Mikrovawe/KiCad2/README.md

# Input Output device

School assignment

In this assignment I received the schematic for this input/output device.
My task was to design the functional blocks and create the documentation as well as designing the 4-layer pcb using KiCad.

In file XX there is the planning of the design
