Mikrovawe/KiCad2/Toiminnalliset_Lohkot.docx

## AI

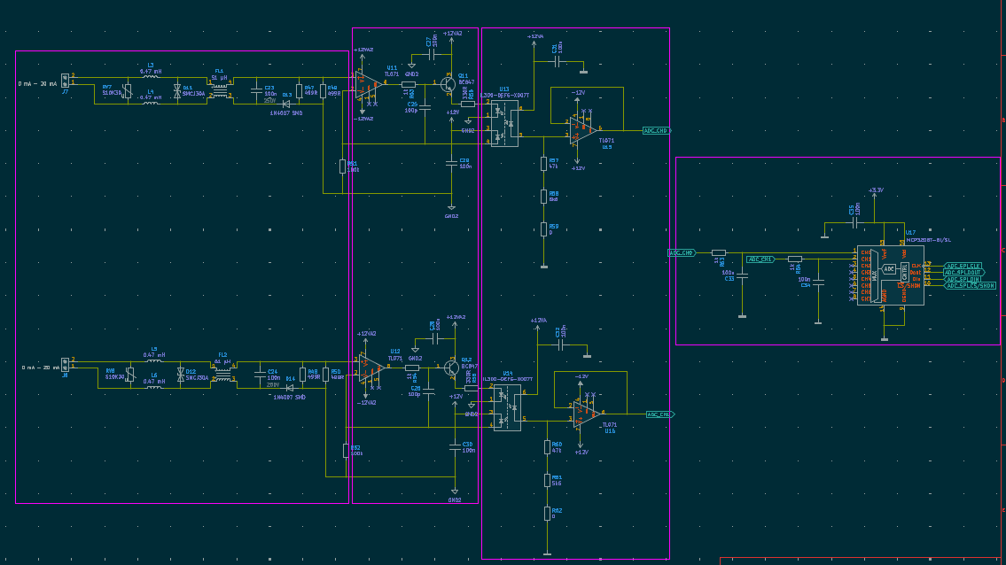
[picture p1: figure]

Lohkot vasemmalta oikealle:

AI – Input -> vasempaan reunaan

AI – Analog improver -> keskemmälle. U11: C54, C58 U12: C61, C64

AI – ADC Buffer -> keskemmälle. U15: C52, C55. U16: C59, C62

AI – ADC -> lähelle cpu:ta, kaukana analogisista signaaleista.

## AO

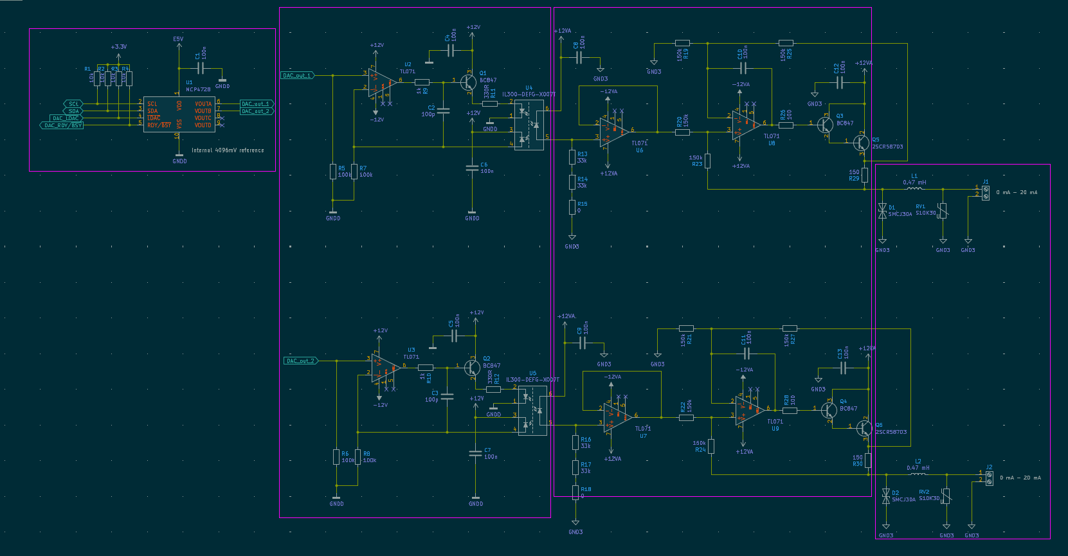
[picture p2: figure]

Lohkot vasemmalta oikealle:

AO – DAC -> CPU:n lähelle, eristyksiin analogisesta signaalista

AO – Analog Improver -> keskemmälle, U2: C65, C68. U3: C36, C44

AO – Output Driver -> keskemmälle, U6: C53, C56. U7: C60, C63. U8: C66, C69 U9: C71, C72

AO – Output -> oikealle reunaan

## DI

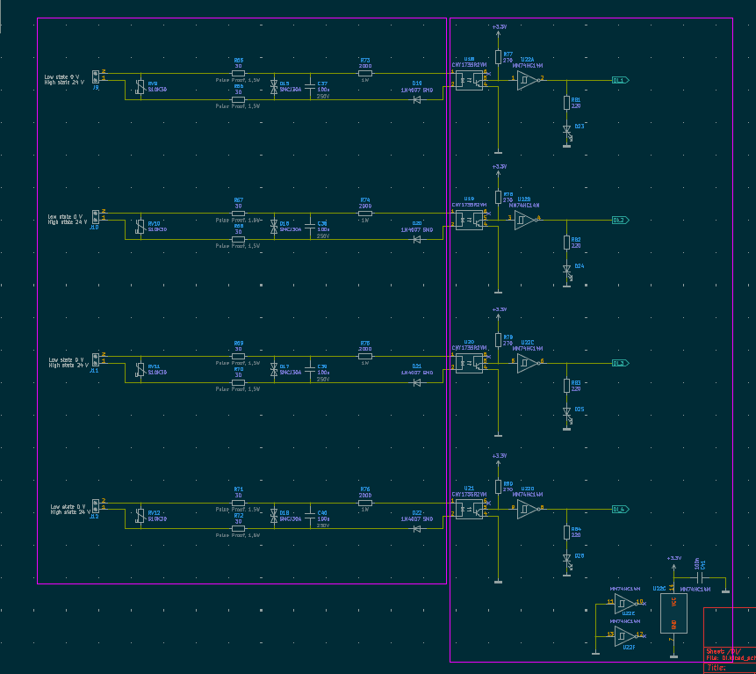
[picture p3: figure]

Lohkot vasemmalta oikealle:

DI – input -> vasen reuna, eristyksiin analogisesta signaalista

DI – Signal improver, lähelle CPU:ta,

## DO

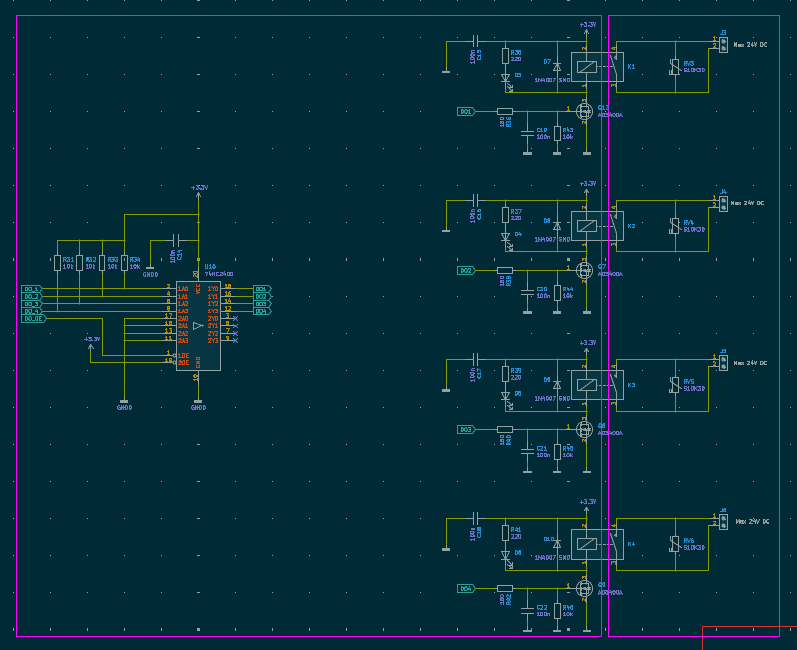
[picture p4: figure]

Lohkot vasemmalta oikealle:

DO – logics, lähelle CPU:ta, erilleen analogisista signaaleista.

DO – Output, oikeaan reunaan

## Power

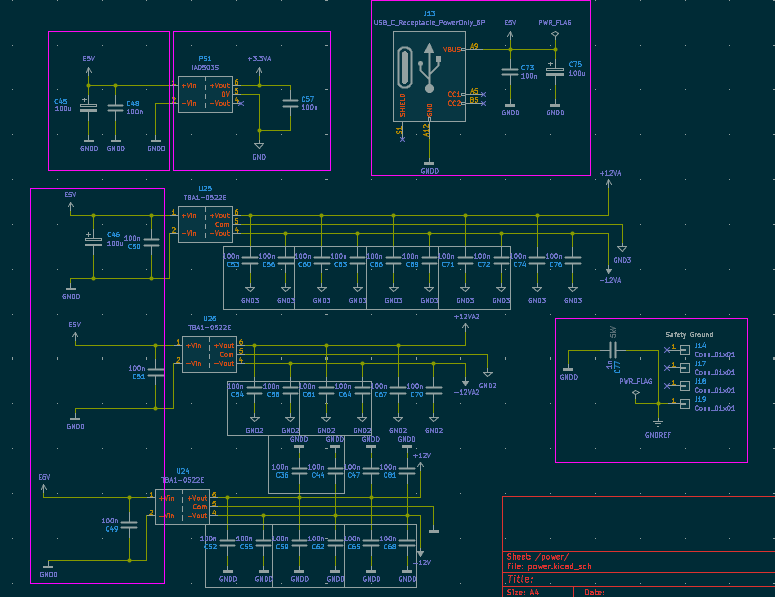
[picture p5: figure]

Lohkot vasemmalta oikealle:

Power – before 12V amp, ylös reunaan

Power – After 12V amp, ei laatikoitu, koska hajautettu ohituskondensaattoreihin.

Power – before 3.3V amp, ylös reunaan

Power – after 3.3V amp, ylös reunaan, erilleen 12V:stä

Power – Input, ylös

Power – Safety ground, jonnekin minne sattuu mahtumaan.

## Communication

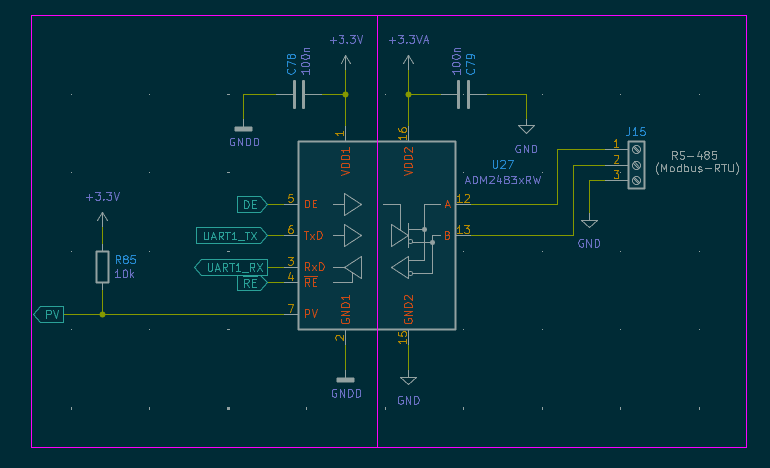
[picture p6: figure]

## CPU

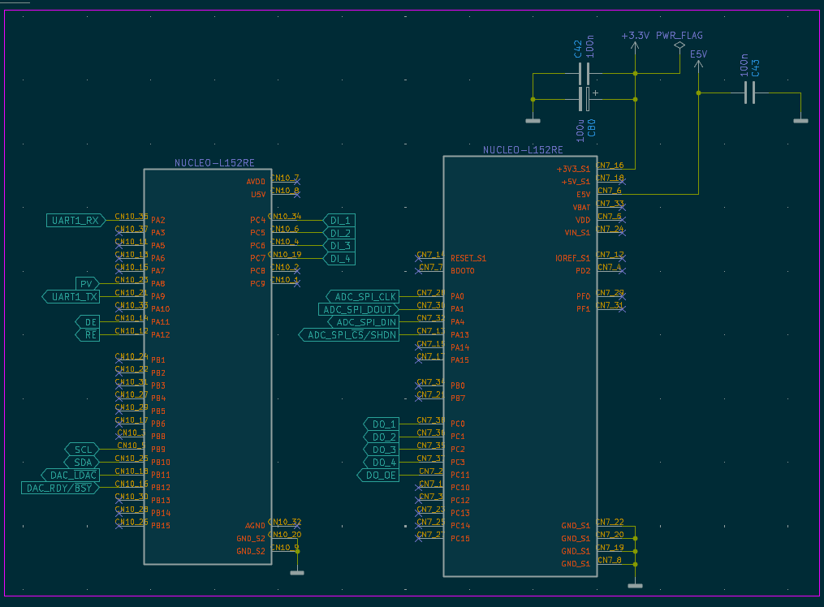
[picture p7: figure]
