Mikrovawe/KiCad2/IO_device.kicad_pcb

## KiCad design IO_device.kicad_pcb (2026-03-13)

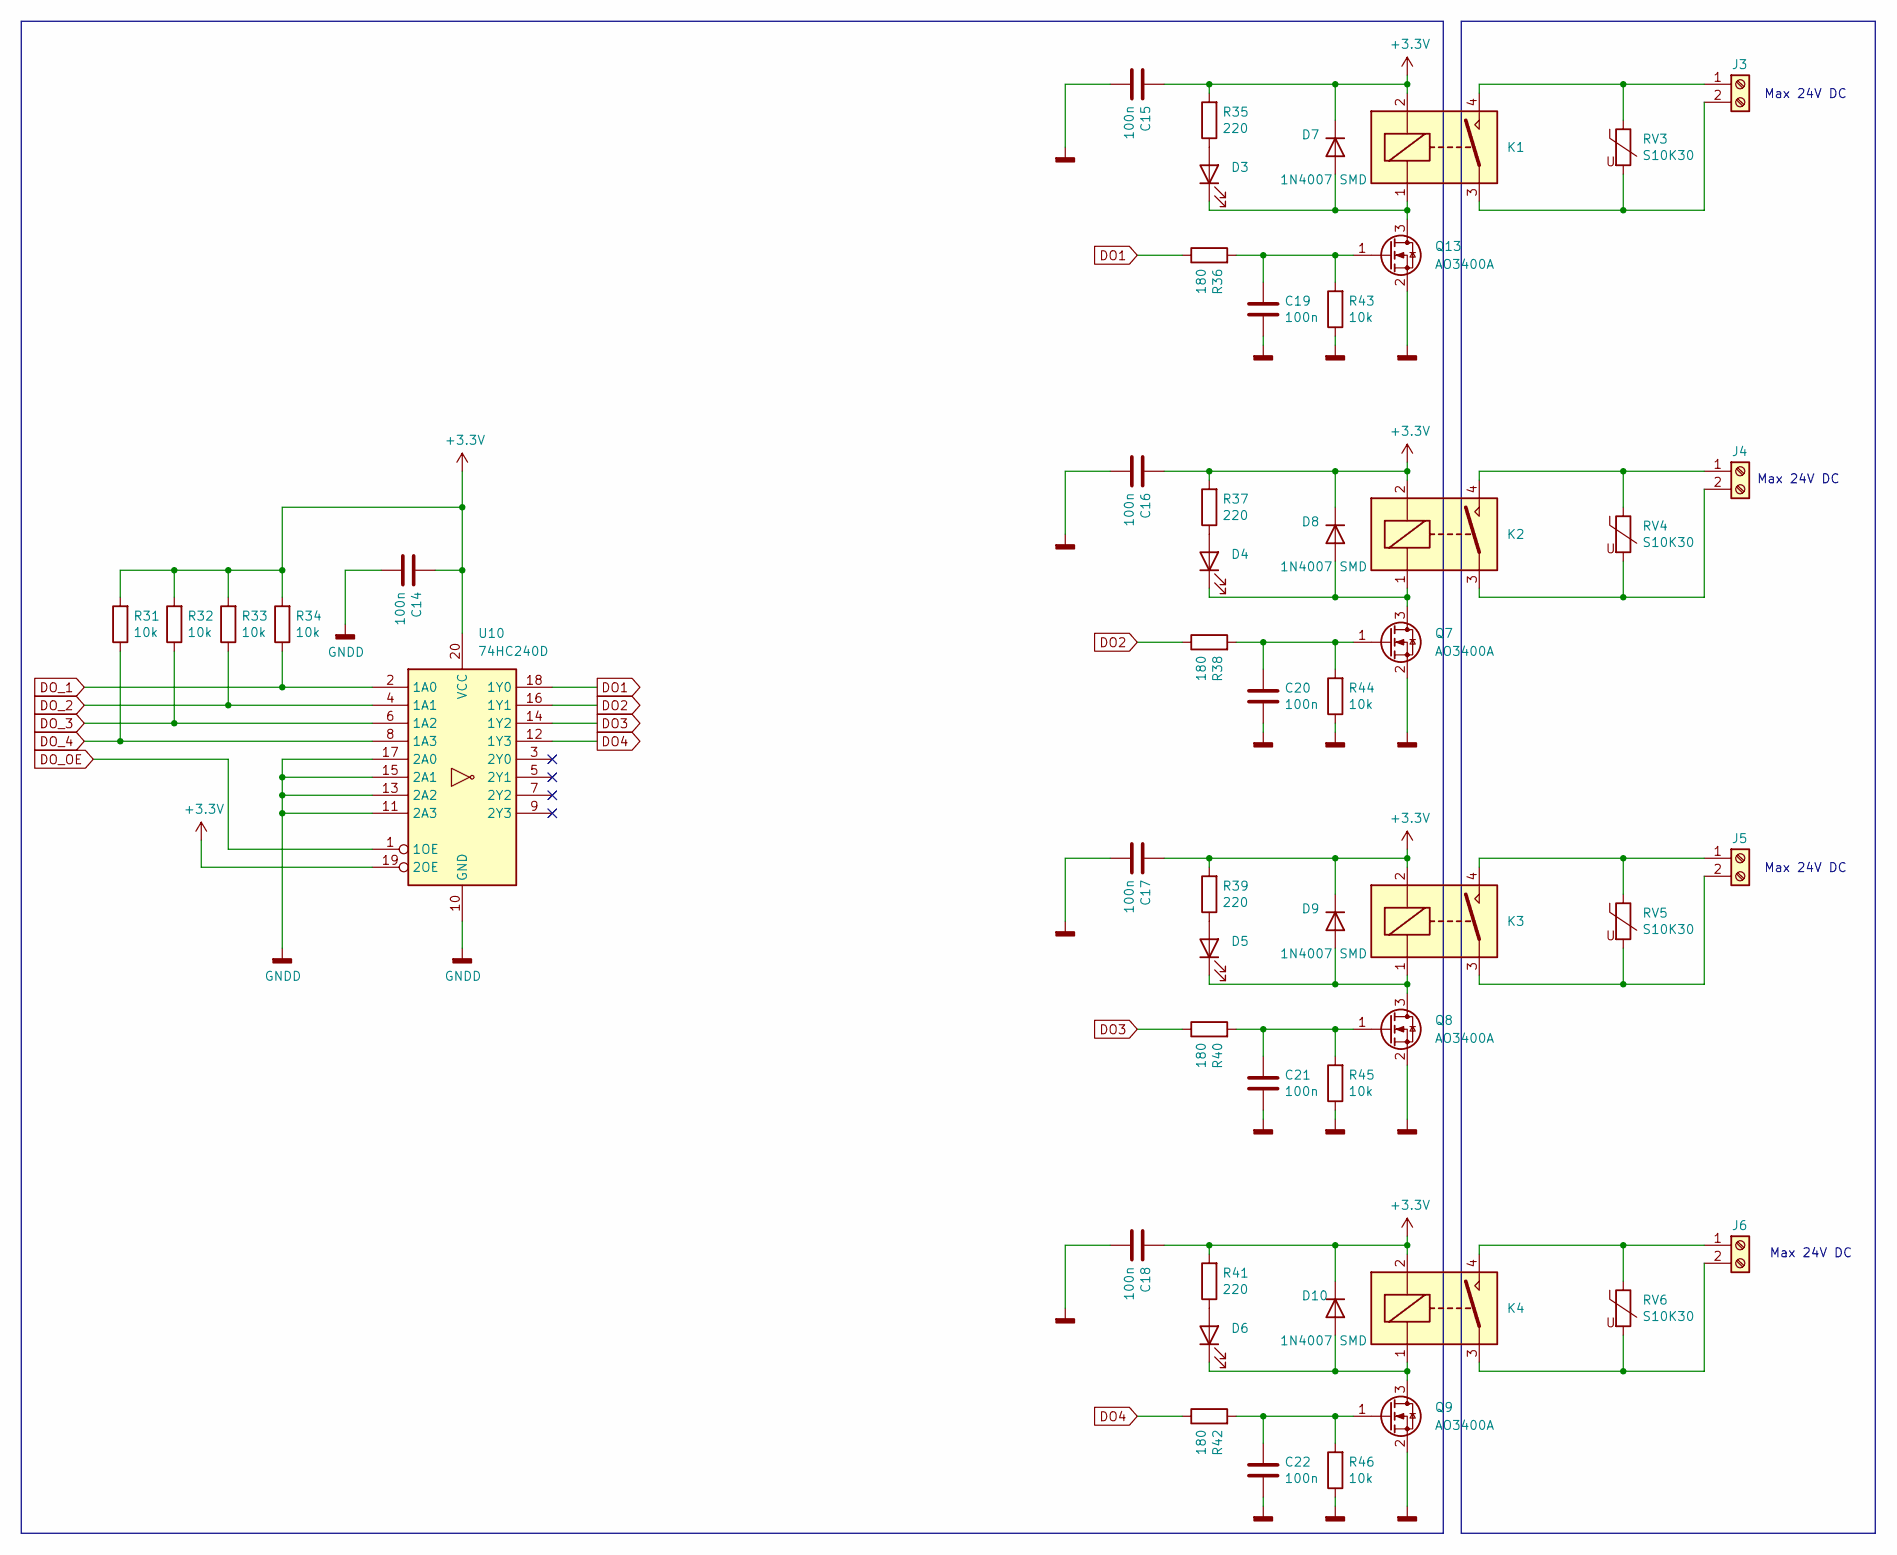
[picture p8: schematic DO.kicad_sch]

Parts:
C14, C15, C16, C17, C18, C19, C20, C21, C22: 100n; C_1206_3216Metric
D3, D4, D5, D6: Green LED 3mm; D_1206_3216Metric
D7, D8, D9, D10: 1N4007 SMD; D_SOD-123
J3, J4, J5, J6: Screw_Terminal_01x02; TerminalBlock_Phoenix_MKDS-3-2-5.08_1x02_P5.08mm_Horizontal
K1, K2, K3, K4: SDT-S-103DMR,000; 1461267-1
Q7, Q8, Q9, Q13: AO3400A; SOT-23
R31, R32, R33, R34, R43, R44, R45, R46: 10k; R_1206_3216Metric
R35, R37, R39, R41: 220; R_1206_3216Metric
R36, R38, R40, R42: 180; R_1206_3216Metric
RV3, RV4, RV5, RV6: S10K30; RV_Disc_D12mm_W5.1mm_P7.5mm
U10: 74HC240D; SOIC-20W_7.5x12.8mm_P1.27mm

Connections:
+3.3V: C14.1, C15.1, C16.1, C17.1, C18.1, D7.1 (K), D8.1 (K), D9.1 (K), D10.1 (K), K1.2, K2.2, K3.2, K4.2, R31.2, R32.2, R33.2, R34.2, R35.2, R37.2, R39.2, R41.2, U10.19 (2OE), U10.20 (VCC); also elsewhere on the board
DO1: R36.1, U10.18 (1Y0)
DO2: R38.1, U10.16 (1Y1)
DO3: R40.1, U10.14 (1Y2)
DO4: R42.1, U10.12 (1Y3)
DO_1: R34.1, U10.2 (1A0); also elsewhere on the board
DO_2: R33.1, U10.4 (1A1); also elsewhere on the board
DO_3: R32.1, U10.6 (1A2); also elsewhere on the board
DO_4: R31.1, U10.8 (1A3); also elsewhere on the board
DO_OE: U10.1 (1OE); also elsewhere on the board
GNDD: C14.2, C15.2, C16.2, C17.2, C18.2, C19.2, C20.2, C21.2, C22.2, Q7.2 (S), Q8.2 (S), Q9.2 (S), Q13.2 (S), R43.1, R44.1, R45.1, R46.1, U10.10 (GND), U10.11 (2A3), U10.13 (2A2), U10.15 (2A1), U10.17 (2A0); also elsewhere on the board
unnamed: D3.2 (A), R35.1
unnamed: D3.1 (K), D7.2 (A), K1.1, Q13.3 (D)
unnamed: D4.2 (A), R37.1
unnamed: D4.1 (K), D8.2 (A), K2.1, Q7.3 (D)
unnamed: D5.2 (A), R39.1
unnamed: D5.1 (K), D9.2 (A), K3.1, Q8.3 (D)
unnamed: D6.2 (A), R41.1
unnamed: D6.1 (K), D10.2 (A), K4.1, Q9.3 (D)
unnamed: J3.1, K1.4, RV3.1
unnamed: J3.2, K1.3, RV3.2
unnamed: J4.1, K2.4, RV4.1
unnamed: J4.2, K2.3, RV4.2
unnamed: J5.1, K3.4, RV5.1
unnamed: J5.2, K3.3, RV5.2
unnamed: J6.1, K4.4, RV6.1
unnamed: J6.2, K4.3, RV6.2
unnamed: C20.1, Q7.1 (G), R38.2, R44.2
unnamed: C21.1, Q8.1 (G), R40.2, R45.2
unnamed: C22.1, Q9.1 (G), R42.2, R46.2
unnamed: C19.1, Q13.1 (G), R36.2, R43.2

Notes on the sheet:
Max 24V DC

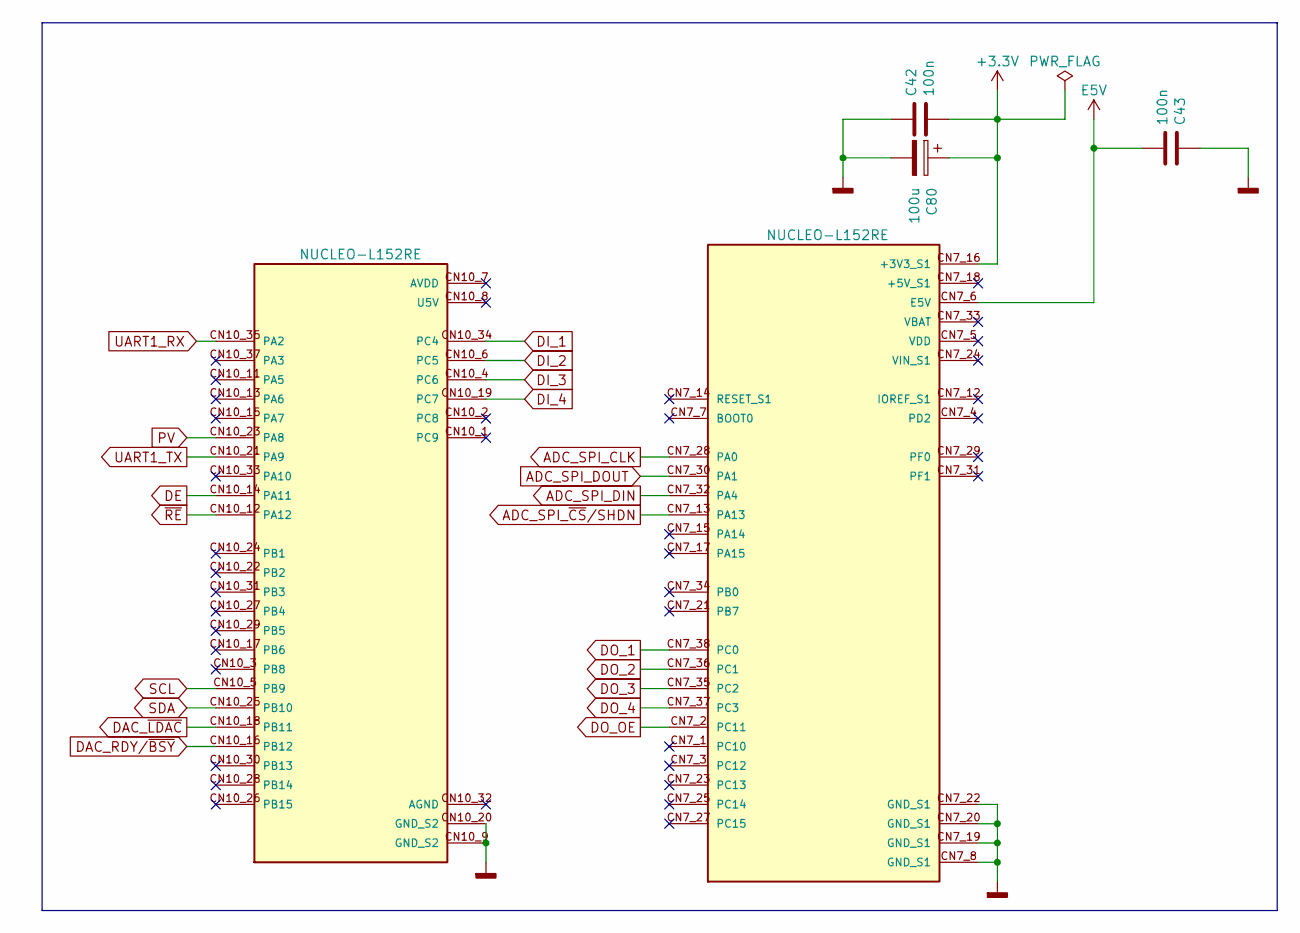
[picture p9: schematic CPU.kicad_sch]

Parts:
C42, C43: 100n; C_1206_3216Metric; Voltage 250V
C80: 100u; CP_Elec_6.3x7.7
U28: NUCLEO-L152RE; ST_NUCLEO-F303RE; PARTREV 14

Connections:
+3.3V: C42.2, C80.1, U28.CN7_16 (+3V3_S1); also elsewhere on the board
ADC_SPI_CLK: U28.CN7_28 (PA0); also elsewhere on the board
ADC_SPI_DIN: U28.CN7_32 (PA4); also elsewhere on the board
ADC_SPI_DOUT: U28.CN7_30 (PA1); also elsewhere on the board
ADC_SPI_~CS/SHDN: U28.CN7_13 (PA13); also elsewhere on the board
DAC_RDY/~BSY: U28.CN10_16 (PB12); also elsewhere on the board
DAC_~LDAC: U28.CN10_18 (PB11); also elsewhere on the board
DE: U28.CN10_14 (PA11); also elsewhere on the board
DI_1: U28.CN10_34 (PC4); also elsewhere on the board
DI_2: U28.CN10_6 (PC5); also elsewhere on the board
DI_3: U28.CN10_4 (PC6); also elsewhere on the board
DI_4: U28.CN10_19 (PC7); also elsewhere on the board
DO_1: U28.CN7_38 (PC0); also elsewhere on the board
DO_2: U28.CN7_36 (PC1); also elsewhere on the board
DO_3: U28.CN7_35 (PC2); also elsewhere on the board
DO_4: U28.CN7_37 (PC3); also elsewhere on the board
DO_OE: U28.CN7_2 (PC11); also elsewhere on the board
E5V: C43.2, U28.CN7_6 (E5V); also elsewhere on the board
GNDD: C42.1, C43.1, C80.2, U28.CN7_8 (GND_S1), U28.CN7_19 (GND_S1), U28.CN7_20 (GND_S1), U28.CN7_22 (GND_S1), U28.CN10_9 (GND_S2), U28.CN10_20 (GND_S2); also elsewhere on the board
PV: U28.CN10_23 (PA8); also elsewhere on the board
SCL: U28.CN10_5 (PB9); also elsewhere on the board
SDA: U28.CN10_25 (PB10); also elsewhere on the board
UART1_RX: U28.CN10_35 (PA2); also elsewhere on the board
UART1_TX: U28.CN10_21 (PA9); also elsewhere on the board
~RE: U28.CN10_12 (PA12); also elsewhere on the board

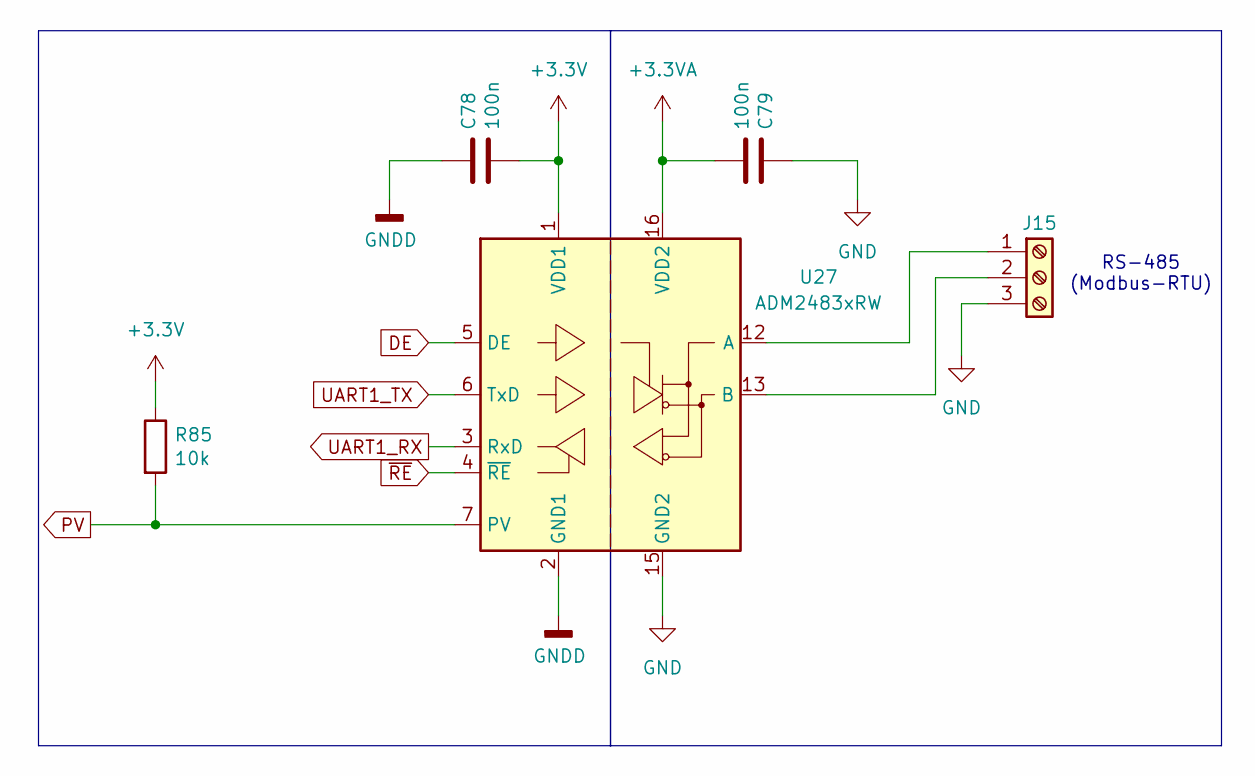
[picture p10: schematic Communication.kicad_sch]

Parts:
C78, C79: 100n; C_1206_3216Metric; Voltage 250V
J15: Screw_Terminal_01x03; TerminalBlock_Phoenix_MKDS-3-3-5.08_1x03_P5.08mm_Horizontal
R85: 10k; C_1206_3216Metric
U27: ADM2483xRW; SOIC-16W_7.5x10.3mm_P1.27mm

Connections:
+3.3V: C78.2, R85.1, U27.1 (VDD1); also elsewhere on the board
+3.3VA: C79.2, U27.16 (VDD2); also elsewhere on the board
DE: U27.5 (DE); also elsewhere on the board
GND: C79.1, J15.3, U27.9 (GND2), U27.15 (GND2); also elsewhere on the board
GNDD: C78.1, U27.2 (GND1), U27.8 (GND1); also elsewhere on the board
unnamed: J15.1, U27.12 (A)
unnamed: J15.2, U27.13 (B)
PV: R85.2, U27.7 (PV); also elsewhere on the board
UART1_RX: U27.3 (RxD); also elsewhere on the board
UART1_TX: U27.6 (TxD); also elsewhere on the board
~RE: U27.4 (~RE); also elsewhere on the board

Notes on the sheet:
RS-485 (Modbus-RTU)

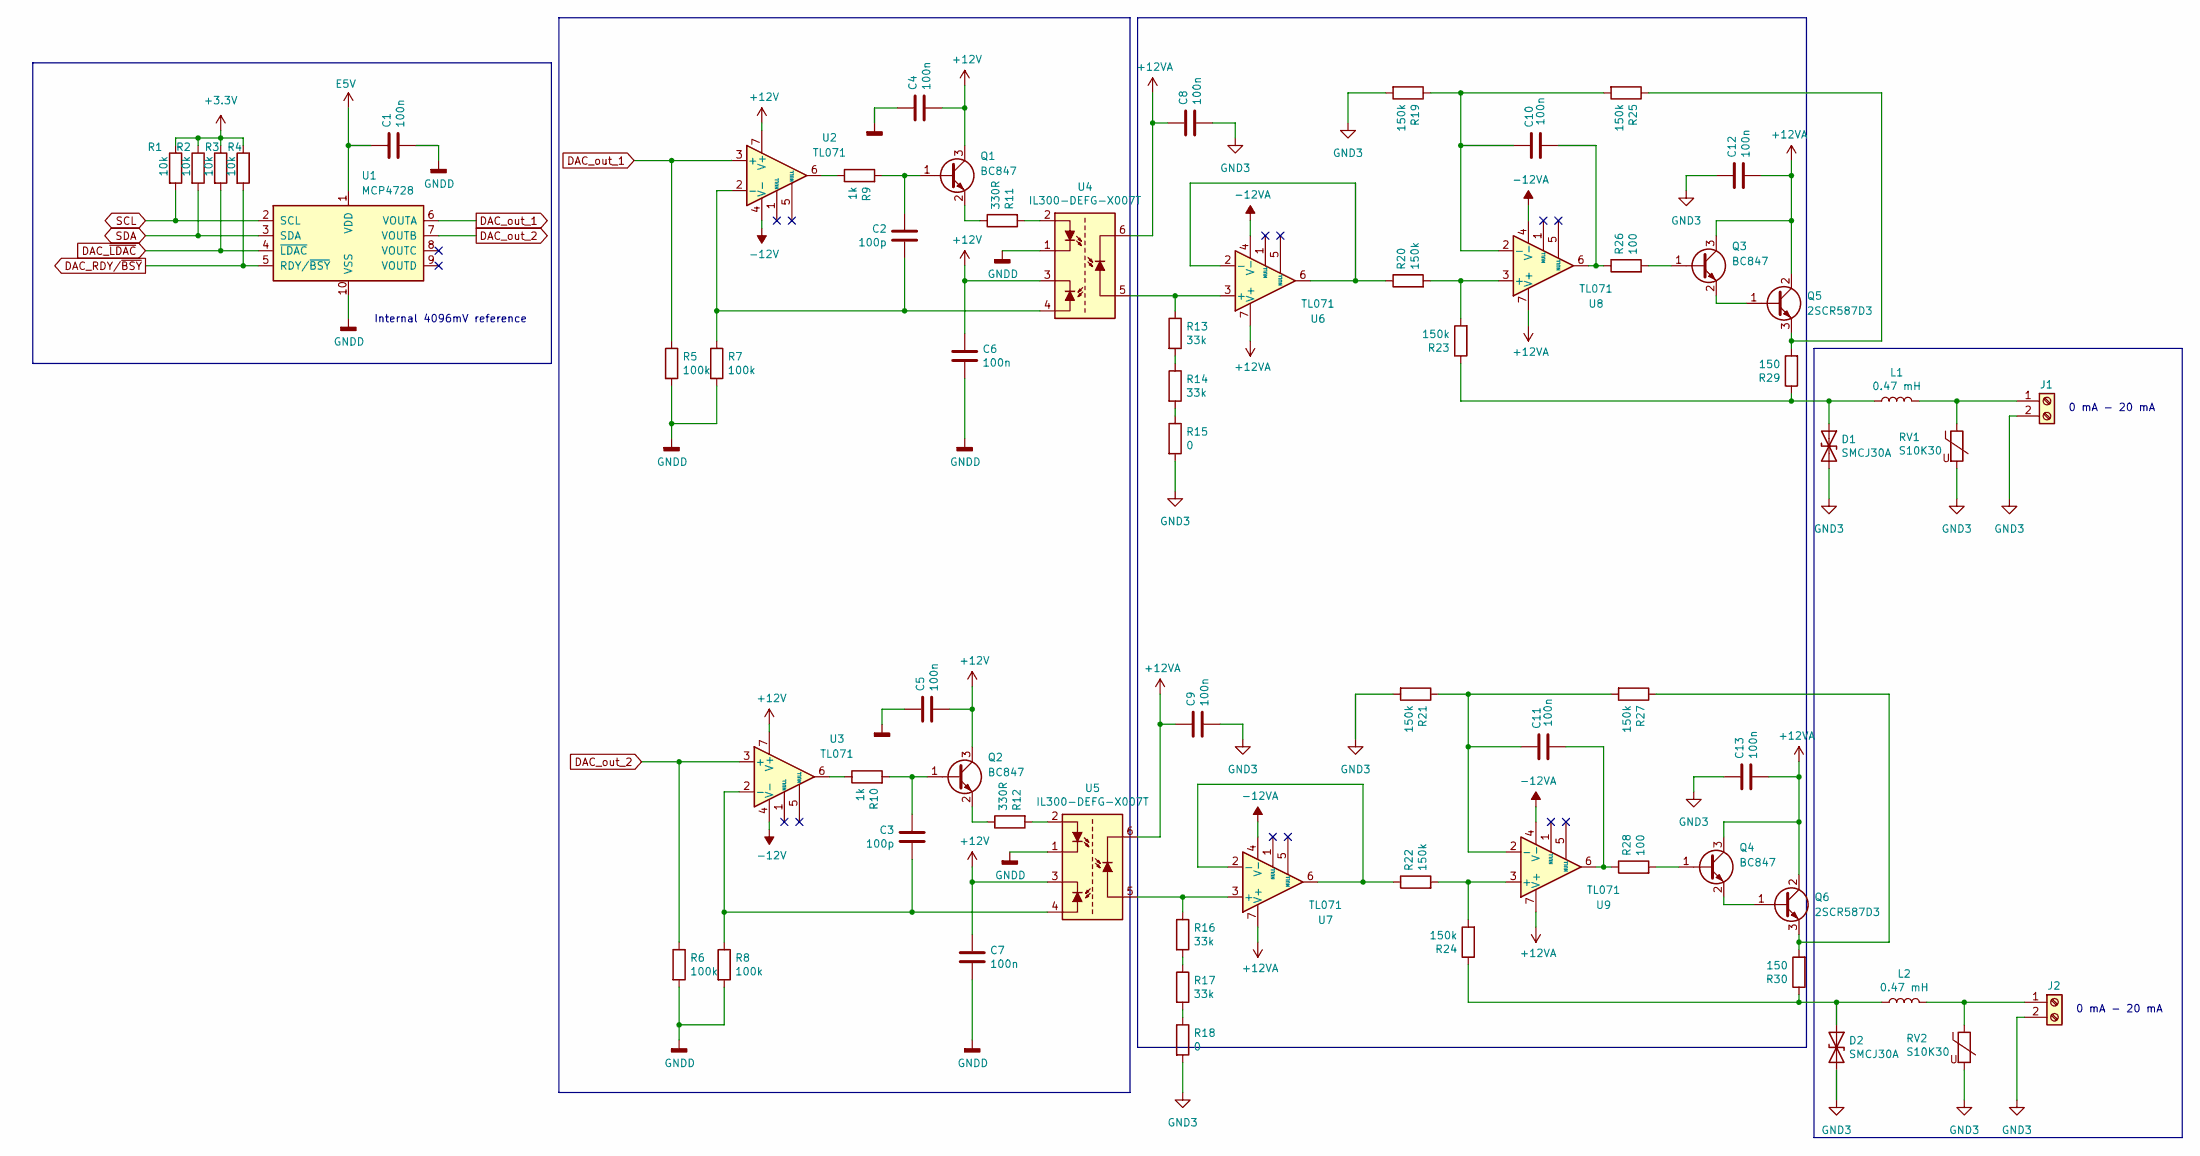
[picture p11: schematic AO.kicad_sch]

Parts:
C1, C4, C5, C8, C9, C12, C13: 100n; C_1206_3216Metric
C2, C3: 100p; C_1206_3216Metric
C6, C7, C10, C11: 100n; R_1206_3216Metric
D1, D2: SMCJ30A; D_SMC
J1, J2: Screw_Terminal_01x02; TerminalBlock_Phoenix_MKDS-3-2-5.08_1x02_P5.08mm_Horizontal
L1, L2: 0.47 mH; L_Radial_D7.8mm_P5.00mm_Fastron_07HCP
Q1, Q2, Q3, Q4: BC847; SOT-23
Q5, Q6: 2SCR587D3; TO-252-2
R1, R2, R3, R4: 10k; R_1206_3216Metric
R5, R6, R7, R8: 100k; R_1206_3216Metric
R9, R10: 1k; D_1206_3216Metric
R11, R12: 330R; R_1020_2550Metric
R13, R14, R16, R17: 33k; R_1206_3216Metric
R15, R18: 0; R_1206_3216Metric
R19, R20, R21, R22, R23, R24, R25, R27: 150k; C_1206_3216Metric
R26, R28: 100; C_1206_3216Metric
R29, R30: 150; C_1206_3216Metric
RV1, RV2: S10K30; RV_Disc_D12mm_W5.1mm_P7.5mm
U1: MCP4728; MSOP-10_3x3mm_P0.5mm
U2, U3, U6, U7, U8, U9: TL071; SOIC-8_3.9x4.9mm_P1.27mm
U4, U5: IL300-DEFG-X007T; DIP-8_W8.89mm_SMDSocket_LongPads

Connections:
+3.3V: R1.1, R2.1, R3.1, R4.1; also elsewhere on the board
+12V: C4.1, C5.1, C6.2, C7.2, Q1.3 (C), Q2.3 (C), U2.7 (V+), U3.7 (V+), U4.3, U5.3; also elsewhere on the board
+12VA: C8.2, C9.2, C12.1, C13.1, Q3.3 (C), Q4.3 (C), Q5.2 (C), Q6.2 (C), U4.6, U5.6, U6.7 (V+), U7.7 (V+), U8.7 (V+), U9.7 (V+); also elsewhere on the board
-12V: U2.4 (V-), U3.4 (V-); also elsewhere on the board
-12VA: U6.4 (V-), U7.4 (V-), U8.4 (V-), U9.4 (V-); also elsewhere on the board
DAC_RDY/~BSY: R4.2, U1.5 (RDY/~BSY); also elsewhere on the board
DAC_out_1: R5.1, U1.6 (VOUTA), U2.3 (+)
DAC_out_2: R6.1, U1.7 (VOUTB), U3.3 (+)
DAC_~LDAC: R3.2, U1.4 (~LDAC); also elsewhere on the board
E5V: C1.2, U1.1 (VDD); also elsewhere on the board
GND3: C8.1, C9.1, C12.2, C13.2, D1.2 (A2), D2.2 (A2), J1.2, J2.2, R15.2, R18.2, R19.2, R21.2, RV1.2, RV2.2; also elsewhere on the board
GNDD: C1.1, C4.2, C5.2, C6.1, C7.1, R5.2, R6.2, R7.2, R8.2, U1.10 (VSS), U4.1, U5.1; also elsewhere on the board
unnamed: C10.1, R26.1, U8.6
unnamed: C11.1, R28.1, U9.6
unnamed: D1.1 (A1), L1.2, R23.1, R29.1
unnamed: D2.1 (A1), L2.2, R24.1, R30.1
unnamed: J1.1, L1.1, RV1.1
unnamed: J2.1, L2.1, RV2.1
unnamed: C2.1, Q1.1 (B), R9.2
unnamed: Q1.2 (E), R11.1
unnamed: C3.1, Q2.1 (B), R10.2
unnamed: Q2.2 (E), R12.1
unnamed: Q3.1 (B), R26.2
unnamed: Q3.2 (E), Q5.1 (B)
unnamed: Q4.1 (B), R28.2
unnamed: Q4.2 (E), Q6.1 (B)
unnamed: Q5.3 (E), R25.1, R29.2
unnamed: Q6.3 (E), R27.1, R30.2
unnamed: R9.1, U2.6
unnamed: R10.1, U3.6
unnamed: R11.2, U4.2
unnamed: R12.2, U5.2
unnamed: R13.2, R14.1
unnamed: R14.2, R15.1
unnamed: R16.2, R17.1
unnamed: R17.2, R18.1
unnamed: C2.2, R7.1, U2.2 (-), U4.4
unnamed: C3.2, R8.1, U3.2 (-), U5.4
unnamed: R13.1, U4.5, U6.3 (+)
unnamed: R20.1, U6.2 (-), U6.6
unnamed: R16.1, U5.5, U7.3 (+)
unnamed: R22.1, U7.2 (-), U7.6
unnamed: R20.2, R23.2, U8.3 (+)
unnamed: C10.2, R19.1, R25.2, U8.2 (-)
unnamed: R22.2, R24.2, U9.3 (+)
unnamed: C11.2, R21.1, R27.2, U9.2 (-)
SCL: R1.2, U1.2 (SCL); also elsewhere on the board
SDA: R2.2, U1.3 (SDA); also elsewhere on the board

Notes on the sheet:
0 mA - 20 mA
Internal 4096mV reference

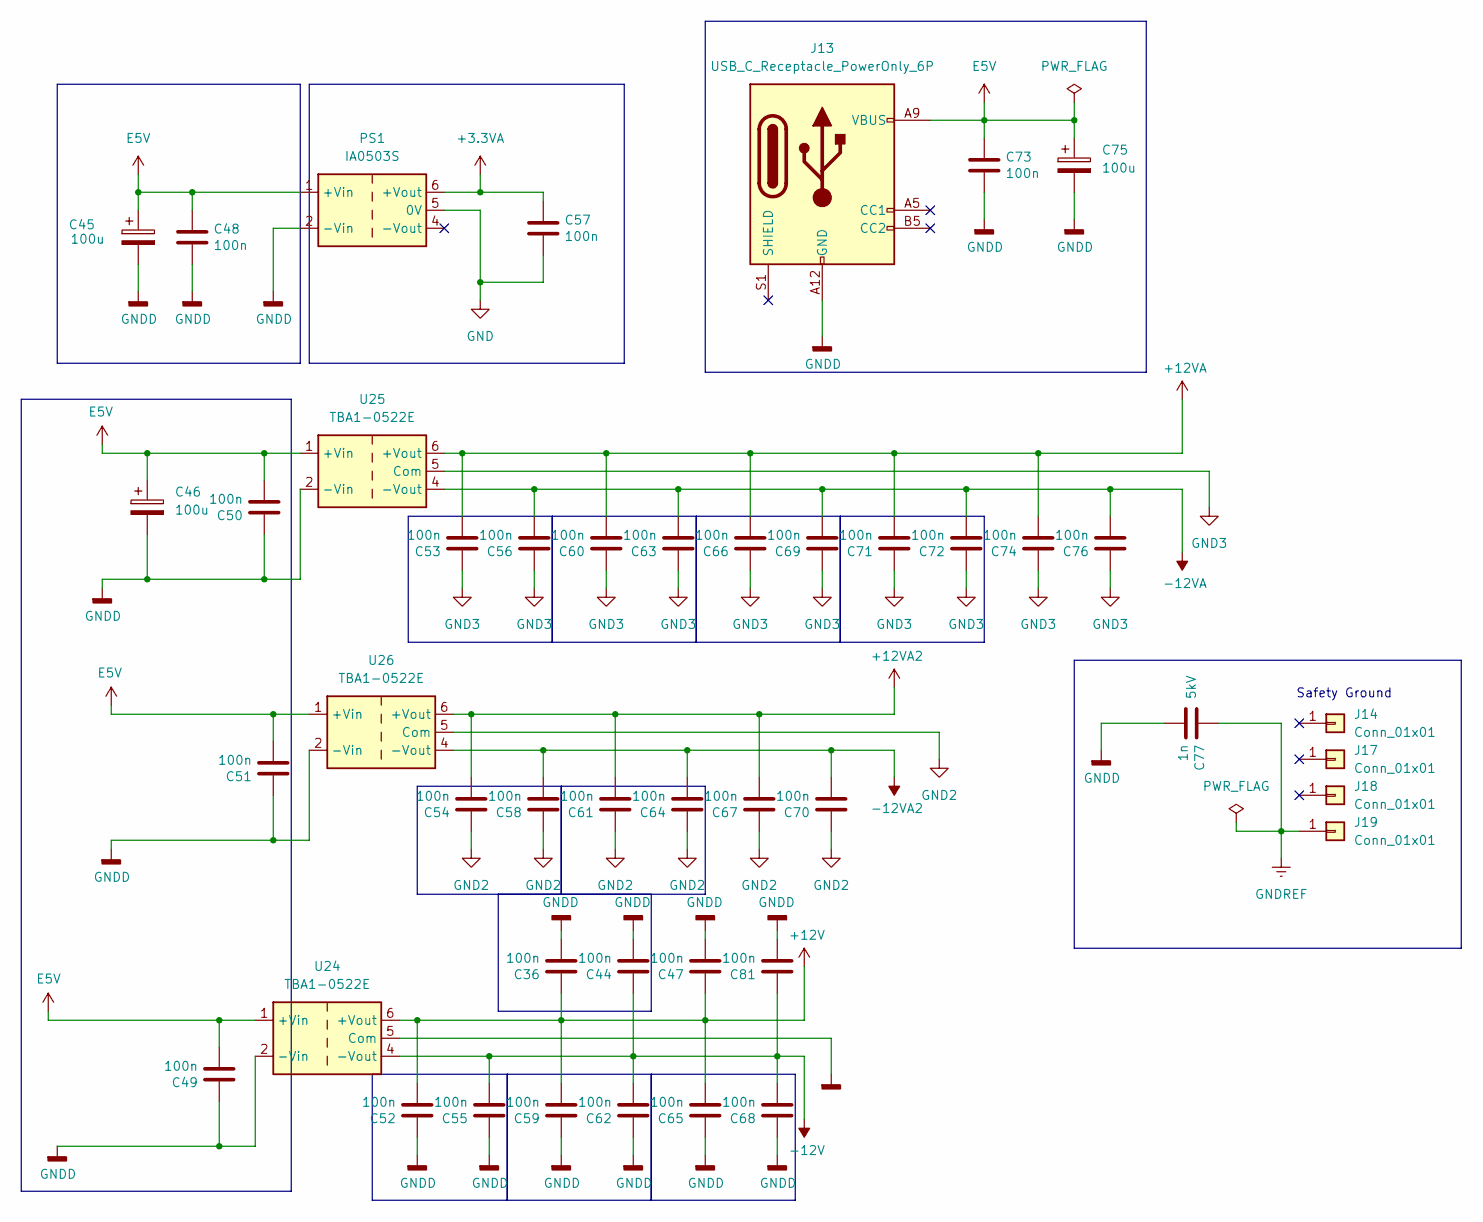
[picture p12: schematic power.kicad_sch]

Parts:
C36, C44, C47, C49, C50, C51, C52, C53, C54, C55, C56, C58, C59, C60, C61, C62, C63, C64, C65, C66, C67, C68, C69, C70, C71, C72, C74, C76, C81: 100n; C_1206_3216Metric
C45, C46, C75: 100u; CP_Elec_6.3x7.7
C48, C57, C73: 100n; C_1206_3216Metric; Voltage 250V
C77: 1n; C_2220_5750Metric; Voltage 5kV
J13: USB_C_Receptacle_PowerOnly_6P; CUI_UJC-HP-3-SMT-TR
J14, J17, J18, J19: Conn_01x01; MountingHole_3.5mm_Pad
PS1: IA0503S; Converter_DCDC_XP_POWER-IAxxxxS_THT
U24, U25, U26: TBA1-0522E; Converter_DCDC_TRACO_TBA1-xxxxE_Dual_THT

Connections:
+3.3VA: C57.1, PS1.6 (+Vout); also elsewhere on the board
+12V: C36.2, C47.2, C52.1, C59.1, C65.1, U24.6 (+Vout); also elsewhere on the board
+12VA: C53.1, C60.1, C66.1, C71.1, C74.1, U25.6 (+Vout); also elsewhere on the board
+12VA2: C54.1, C61.1, C67.1, U26.6 (+Vout); also elsewhere on the board
-12V: C44.2, C55.1, C62.1, C68.1, C81.2, U24.4 (-Vout); also elsewhere on the board
-12VA: C56.1, C63.1, C69.1, C72.1, C76.1, U25.4 (-Vout); also elsewhere on the board
-12VA2: C58.1, C64.1, C70.1, U26.4 (-Vout); also elsewhere on the board
E5V: C45.1, C46.1, C48.1, C49.1, C50.1, C51.1, C73.1, C75.1, J13.A9 (VBUS), J13.B9 (VBUS), PS1.1 (+Vin), U24.1 (+Vin), U25.1 (+Vin), U26.1 (+Vin); also elsewhere on the board
GND: C57.2, PS1.5 (0V); also elsewhere on the board
GND2: C54.2, C58.2, C61.2, C64.2, C67.2, C70.2, U26.5 (Com); also elsewhere on the board
GND3: C53.2, C56.2, C60.2, C63.2, C66.2, C69.2, C71.2, C72.2, C74.2, C76.2, U25.5 (Com); also elsewhere on the board
GNDD: C36.1, C44.1, C45.2, C46.2, C47.1, C48.2, C49.2, C50.2, C51.2, C52.2, C55.2, C59.2, C62.2, C65.2, C68.2, C73.2, C75.2, C77.2, C81.1, J13.A12 (GND), J13.B12 (GND), PS1.2 (-Vin), U24.2 (-Vin), U24.5 (Com), U25.2 (-Vin), U26.2 (-Vin); also elsewhere on the board
GNDREF: C77.1, J19.1

Notes on the sheet:
Safety Ground

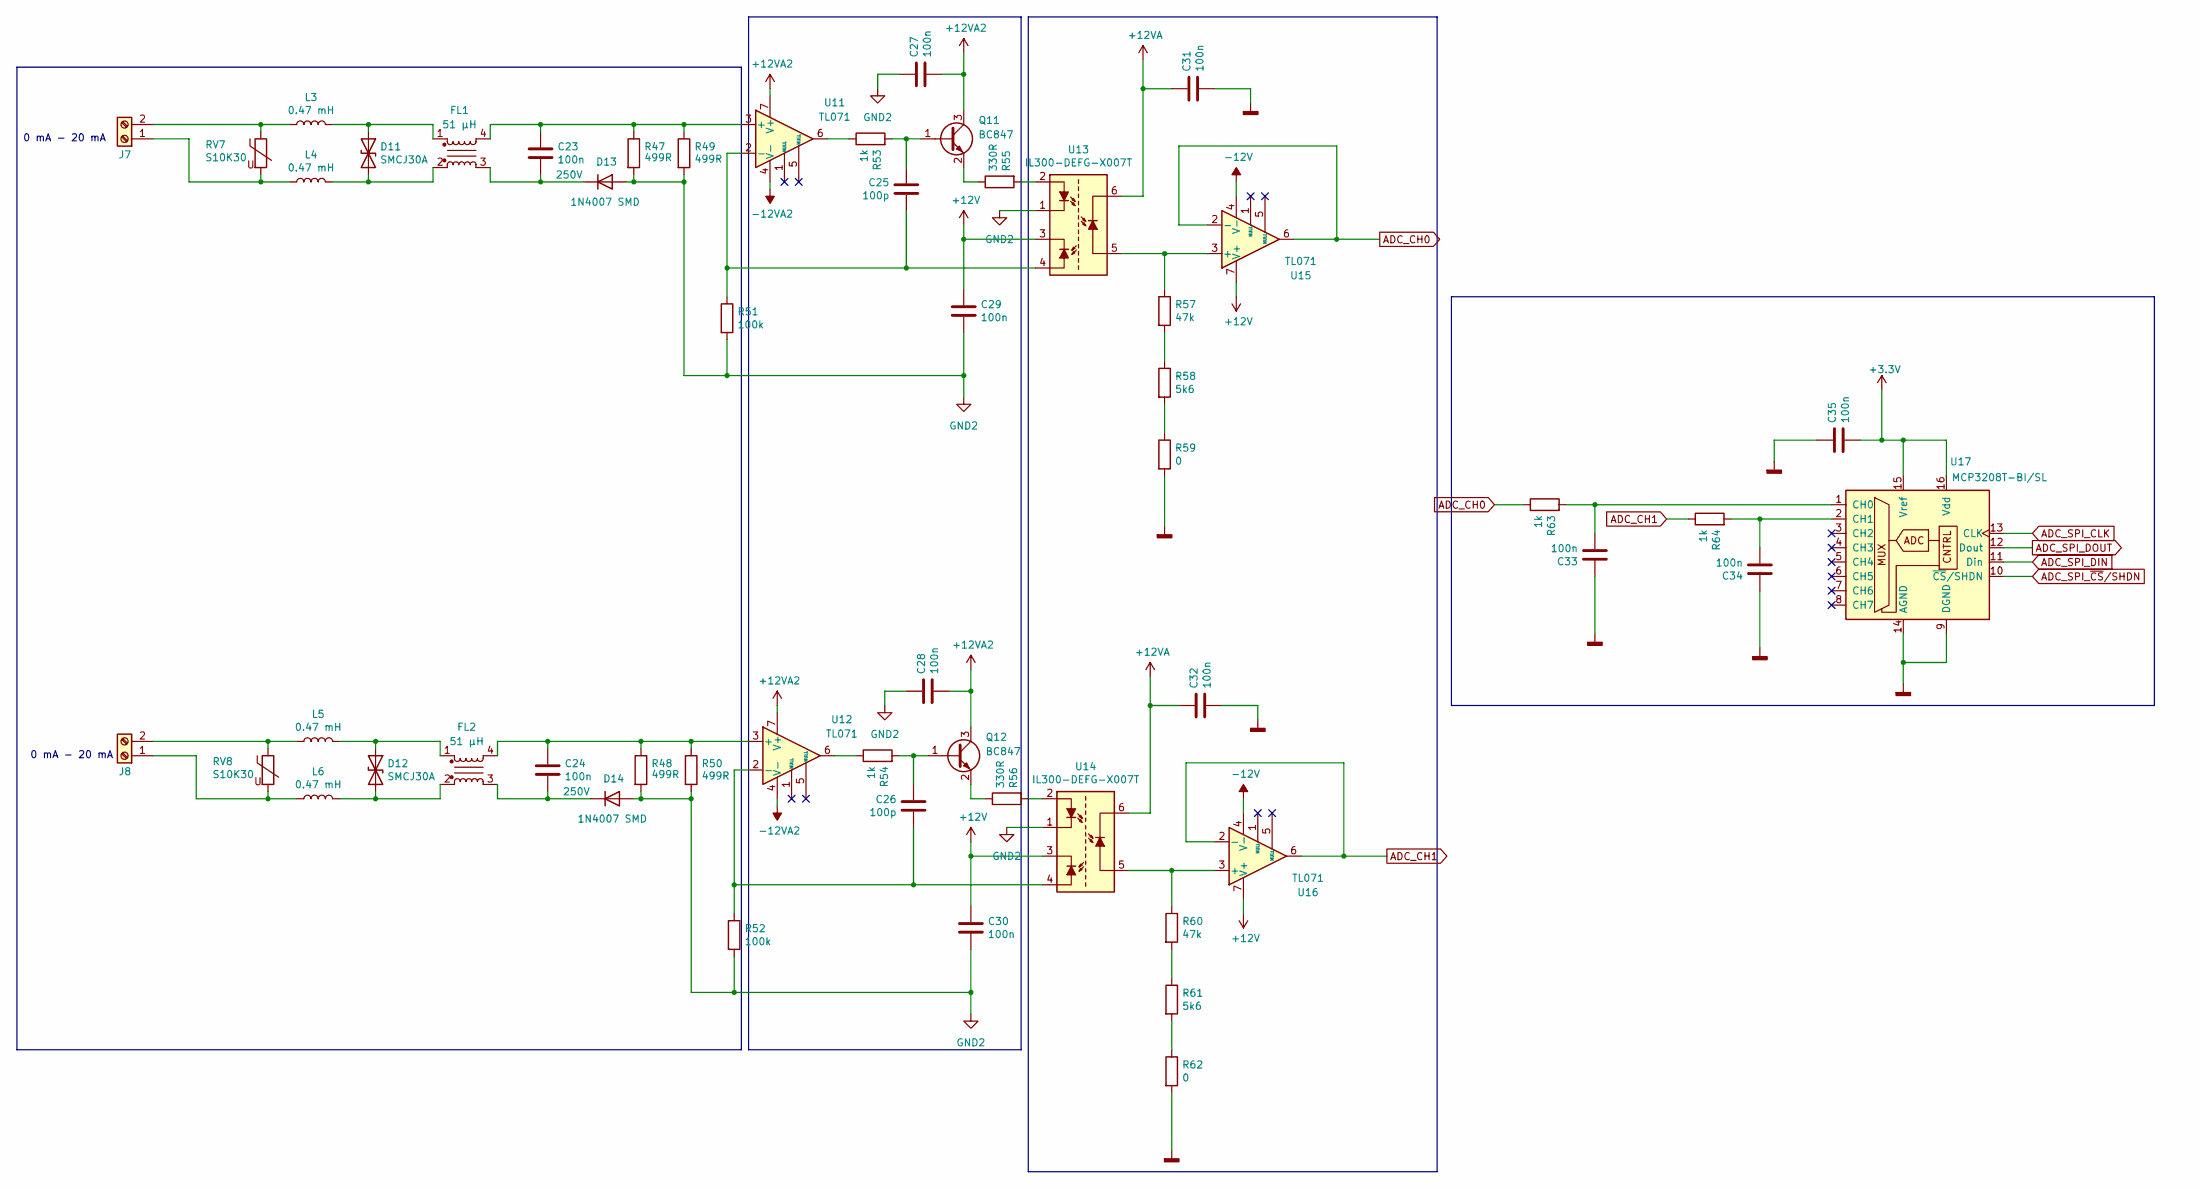
[picture p13: schematic AI.kicad_sch]

Parts:
C23, C24: 100n; C_1206_3216Metric; Voltage 250V
C25, C26: 100p; C_1206_3216Metric
C27, C28, C31, C32, C33, C34, C35: 100n; C_1206_3216Metric
C29, C30: 100n; R_1206_3216Metric
D11, D12: SMCJ30A; D_SMC
D13, D14: 1N4007 SMD; D_SOD-123
FL1, FL2: 51 µH; L_CommonMode_Wuerth_WE-SL2
J7, J8: Screw_Terminal_01x02; TerminalBlock_Phoenix_MKDS-3-2-5.08_1x02_P5.08mm_Horizontal
L3, L4, L5, L6: 0.47 mH; L_Radial_D7.8mm_P5.00mm_Fastron_07HCP
Q11, Q12: BC847; SOT-23
R47, R48, R49, R50: 499R; R_1206_3216Metric
R51, R52: 100k; R_1206_3216Metric
R53, R54, R63, R64: 1k; D_1206_3216Metric
R55, R56: 330R; R_1020_2550Metric
R57, R60: 47k; C_1206_3216Metric
R58, R61: 5k6; R_1206_3216Metric
R59, R62: 0; R_1206_3216Metric
RV7, RV8: S10K30; RV_Disc_D12mm_W5.1mm_P7.5mm
U11, U12, U15, U16: TL071; SOIC-8_3.9x4.9mm_P1.27mm
U13, U14: IL300-DEFG-X007T; DIP-8_W8.89mm_SMDSocket_LongPads
U17: MCP3208T-BI/SL; SOIC-16W_5.3x10.2mm_P1.27mm

Connections:
+3.3V: C35.1, U17.15 (Vref), U17.16 (Vdd); also elsewhere on the board
+12V: C29.2, C30.2, U13.3, U14.3, U15.7 (V+), U16.7 (V+); also elsewhere on the board
+12VA: C31.2, C32.2, U13.6, U14.6; also elsewhere on the board
+12VA2: C27.1, C28.1, Q11.3 (C), Q12.3 (C), U11.7 (V+), U12.7 (V+); also elsewhere on the board
-12V: U15.4 (V-), U16.4 (V-); also elsewhere on the board
-12VA2: U11.4 (V-), U12.4 (V-); also elsewhere on the board
ADC_CH0: R63.1, U15.2 (-), U15.6
ADC_CH1: R64.1, U16.2 (-), U16.6
ADC_SPI_CLK: U17.13 (CLK); also elsewhere on the board
ADC_SPI_DIN: U17.11 (Din); also elsewhere on the board
ADC_SPI_DOUT: U17.12 (Dout); also elsewhere on the board
ADC_SPI_~CS/SHDN: U17.10 (~CS/SHDN); also elsewhere on the board
GND2: C27.2, C28.2, C29.1, C30.1, D13.2 (A), D14.2 (A), R47.2, R48.2, R49.2, R50.2, R51.2, R52.2, U13.1, U14.1; also elsewhere on the board
GNDD: C31.1, C32.1, C33.2, C34.2, C35.2, R59.2, R62.2, U17.9 (DGND), U17.14 (AGND); also elsewhere on the board
unnamed: D11.1 (A1), FL1.1, L3.1
unnamed: D11.2 (A2), FL1.2, L4.1
unnamed: D12.1 (A1), FL2.1, L5.1
unnamed: D12.2 (A2), FL2.2, L6.1
unnamed: C23.2, D13.1 (K), FL1.3
unnamed: C24.2, D14.1 (K), FL2.3
unnamed: J7.1, L4.2, RV7.2
unnamed: J7.2, L3.2, RV7.1
unnamed: J8.1, L6.2, RV8.2
unnamed: J8.2, L5.2, RV8.1
unnamed: C25.1, Q11.1 (B), R53.2
unnamed: Q11.2 (E), R55.1
unnamed: C26.1, Q12.1 (B), R54.2
unnamed: Q12.2 (E), R56.1
unnamed: R53.1, U11.6
unnamed: R54.1, U12.6
unnamed: R55.2, U13.2
unnamed: R56.2, U14.2
unnamed: R57.2, R58.1
unnamed: R58.2, R59.1
unnamed: R60.2, R61.1
unnamed: R61.2, R62.1
unnamed: C23.1, FL1.4, R47.1, R49.1, U11.3 (+)
unnamed: C25.2, R51.1, U11.2 (-), U13.4
unnamed: C24.1, FL2.4, R48.1, R50.1, U12.3 (+)
unnamed: C26.2, R52.1, U12.2 (-), U14.4
unnamed: R57.1, U13.5, U15.3 (+)
unnamed: R60.1, U14.5, U16.3 (+)
unnamed: C33.1, R63.2, U17.1 (CH0)
unnamed: C34.1, R64.2, U17.2 (CH1)

Notes on the sheet:
0 mA - 20 mA
