Mikrovawe/KiCad2/IO_device.kicad_pcb

## KiCad design IO_device.kicad_pcb (continued)

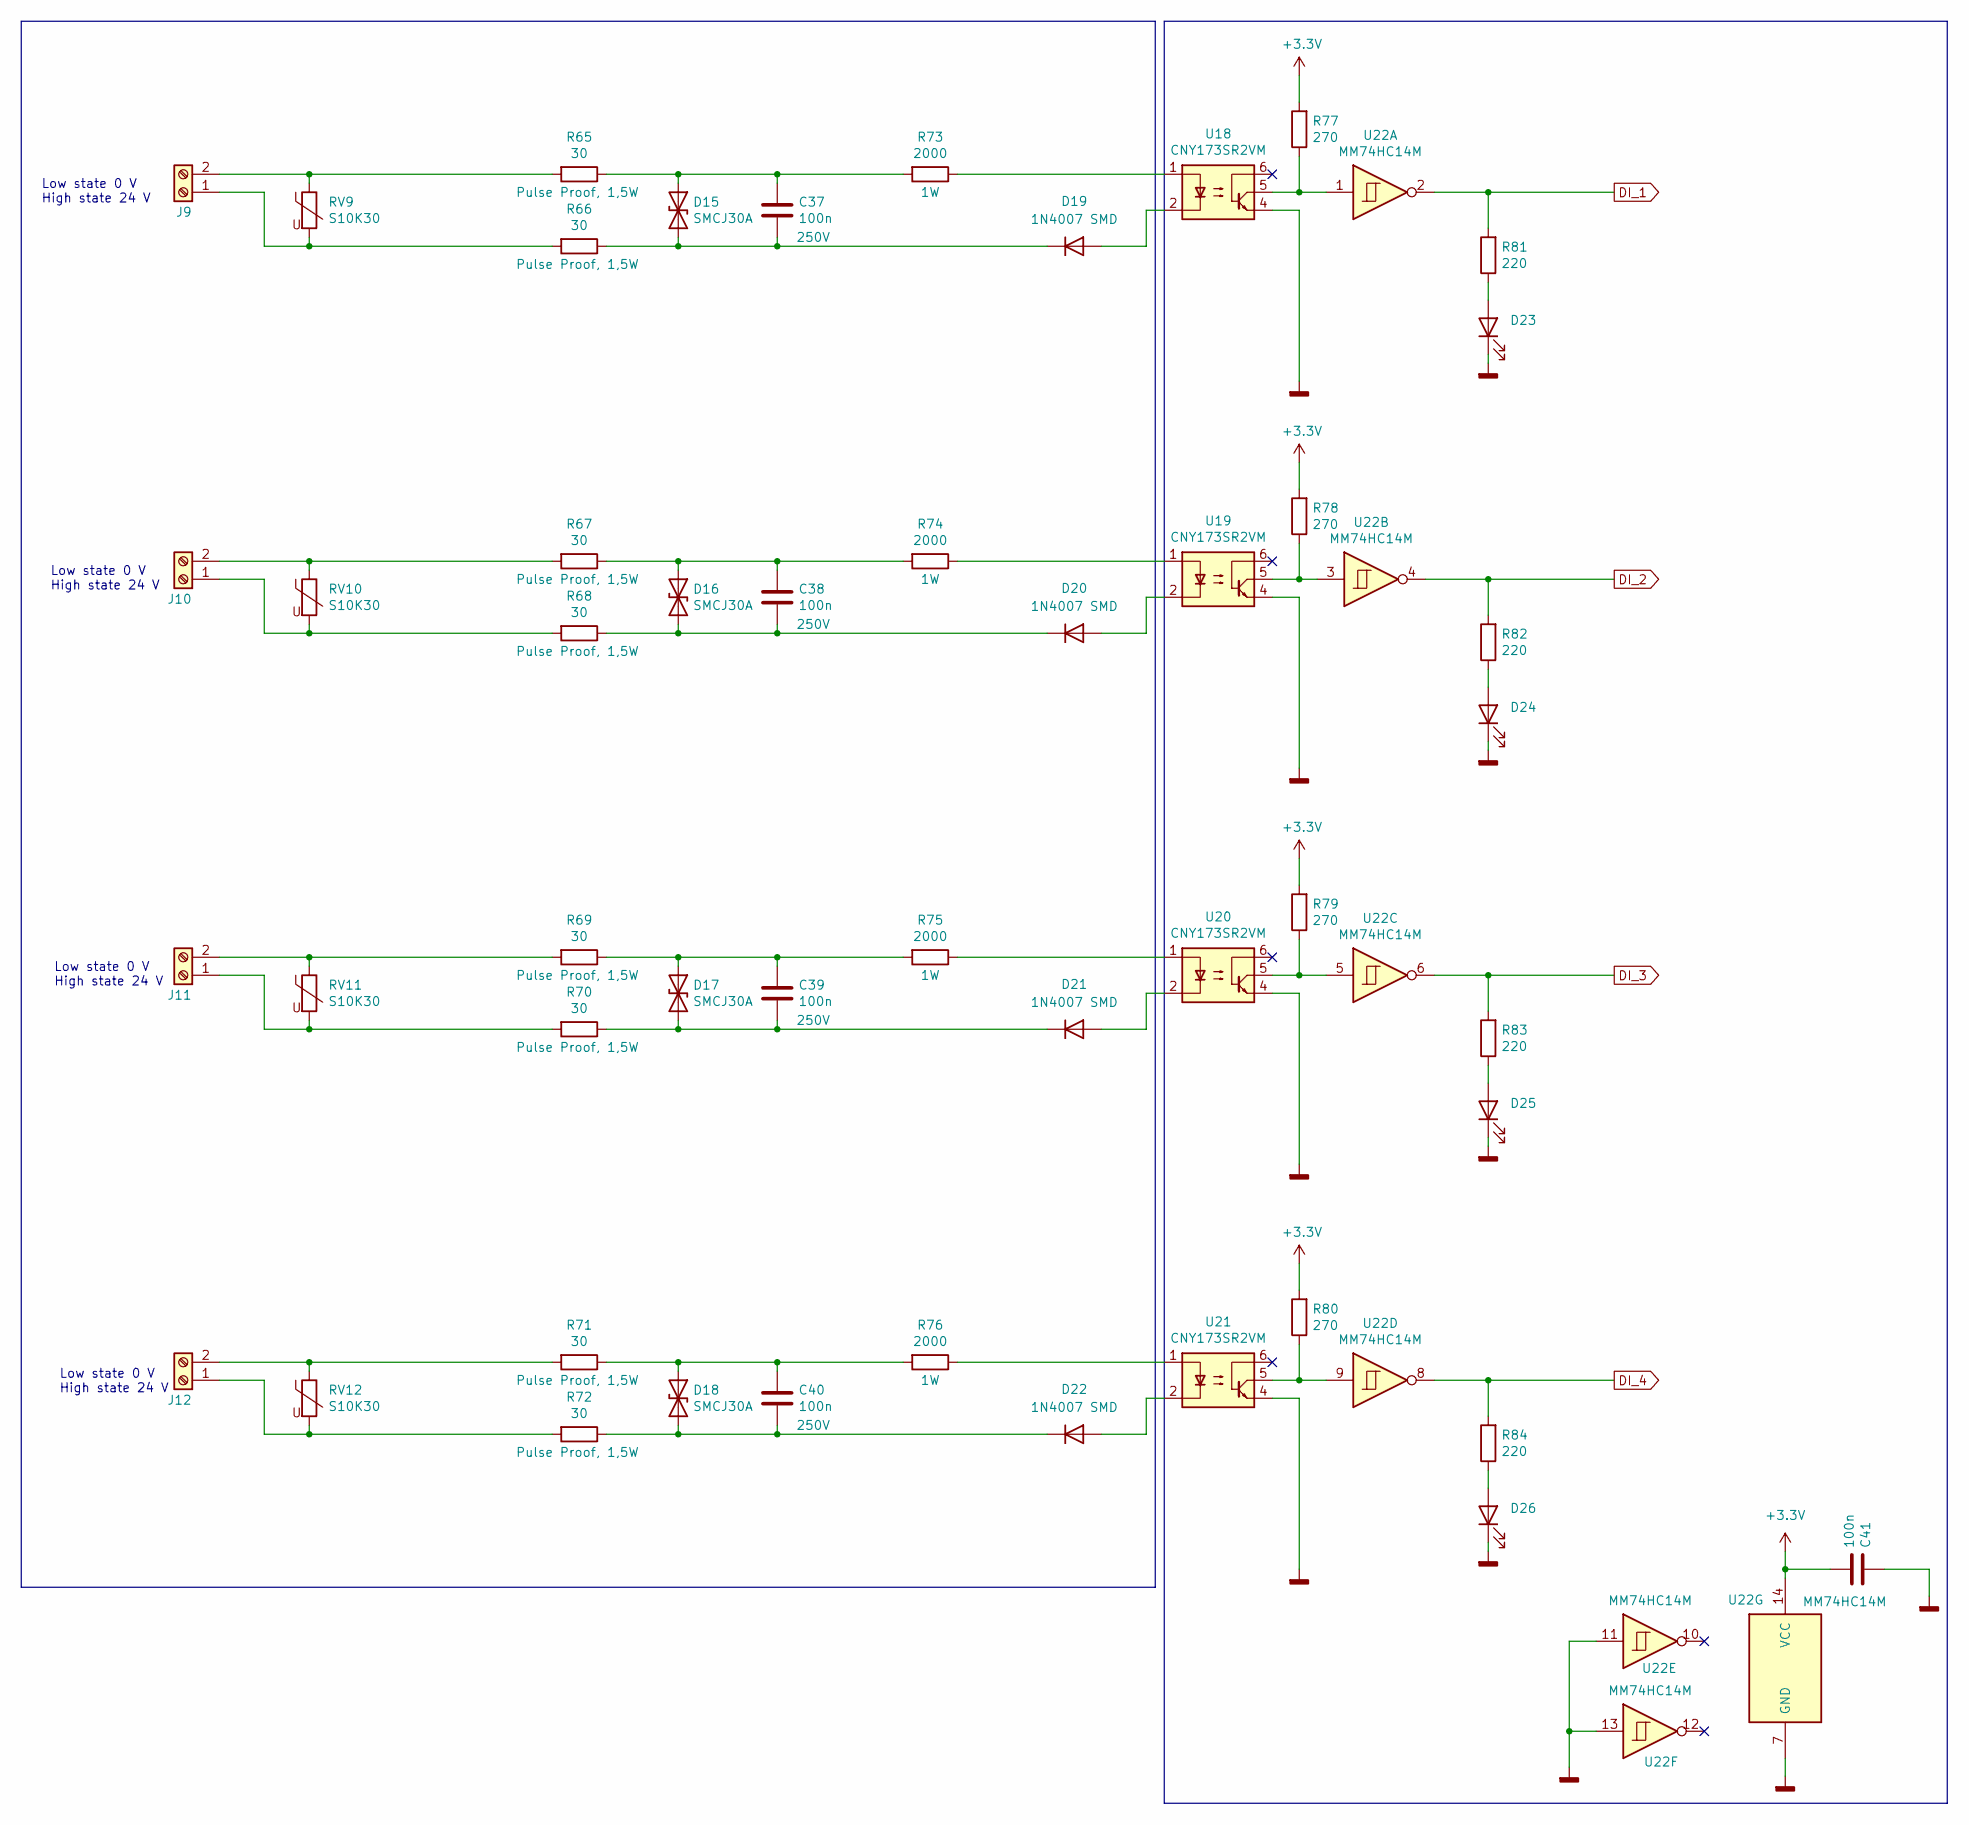
[picture p14: schematic DI.kicad_sch]

Parts:
C37, C38, C39, C40: 100n; C_1206_3216Metric; Voltage 250V
C41: 100n; C_1206_3216Metric
D15, D16, D17, D18: SMCJ30A; D_SMC
D19, D20, D21, D22: 1N4007 SMD; D_SOD-123
D23, D24, D25, D26: Green LED 3mm; D_1206_3216Metric
J9, J10, J11, J12: Screw_Terminal_01x02; TerminalBlock_Phoenix_MKDS-3-2-5.08_1x02_P5.08mm_Horizontal
R65, R66, R67, R68, R69, R70, R71, R72: 30; R_2512_6332Metric; Voltage Pulse Proof, 1,5W
R73, R74, R75, R76: 2000; R_2512_6332Metric
R77, R78, R79, R80: 270; R_1206_3216Metric
R81, R82, R83, R84: 220; R_1206_3216Metric
RV9, RV10, RV11, RV12: S10K30; RV_Disc_D12mm_W5.1mm_P7.5mm
U18, U19, U20, U21: CNY173SR2VM; DIP-6_W7.62mm_SMDSocket_SmallPads
U22: MM74HC14M; SOIC-14_3.9x8.7mm_P1.27mm

Connections:
+3.3V: C41.2, R77.2, R78.2, R79.2, R80.2, U22.14 (VCC); also elsewhere on the board
DI_1: R81.2, U22.2; also elsewhere on the board
DI_2: R82.2, U22.4; also elsewhere on the board
DI_3: R83.2, U22.6; also elsewhere on the board
DI_4: R84.2, U22.8; also elsewhere on the board
GNDD: C41.1, D23.1 (K), D24.1 (K), D25.1 (K), D26.1 (K), U18.4, U19.4, U20.4, U21.4, U22.7 (GND), U22.11, U22.13; also elsewhere on the board
unnamed: C37.1, D15.1 (A1), R65.1, R73.2
unnamed: C37.2, D15.2 (A2), D19.1 (K), R66.1
unnamed: C38.1, D16.1 (A1), R67.1, R74.2
unnamed: C38.2, D16.2 (A2), D20.1 (K), R68.1
unnamed: C39.1, D17.1 (A1), R69.1, R75.2
unnamed: C39.2, D17.2 (A2), D21.1 (K), R70.1
unnamed: C40.1, D18.1 (A1), R71.1, R76.2
unnamed: C40.2, D18.2 (A2), D22.1 (K), R72.1
unnamed: D19.2 (A), U18.2
unnamed: D20.2 (A), U19.2
unnamed: D21.2 (A), U20.2
unnamed: D22.2 (A), U21.2
unnamed: D23.2 (A), R81.1
unnamed: D24.2 (A), R82.1
unnamed: D25.2 (A), R83.1
unnamed: D26.2 (A), R84.1
unnamed: J9.1, R66.2, RV9.2
unnamed: J9.2, R65.2, RV9.1
unnamed: J10.1, R68.2, RV10.2
unnamed: J10.2, R67.2, RV10.1
unnamed: J11.1, R70.2, RV11.2
unnamed: J11.2, R69.2, RV11.1
unnamed: J12.1, R72.2, RV12.2
unnamed: J12.2, R71.2, RV12.1
unnamed: R73.1, U18.1
unnamed: R74.1, U19.1
unnamed: R75.1, U20.1
unnamed: R76.1, U21.1
unnamed: R77.1, U18.5, U22.1
unnamed: R78.1, U19.5, U22.3
unnamed: R79.1, U20.5, U22.5
unnamed: R80.1, U21.5, U22.9

Notes on the sheet:
Low state 0 V High state 24 V

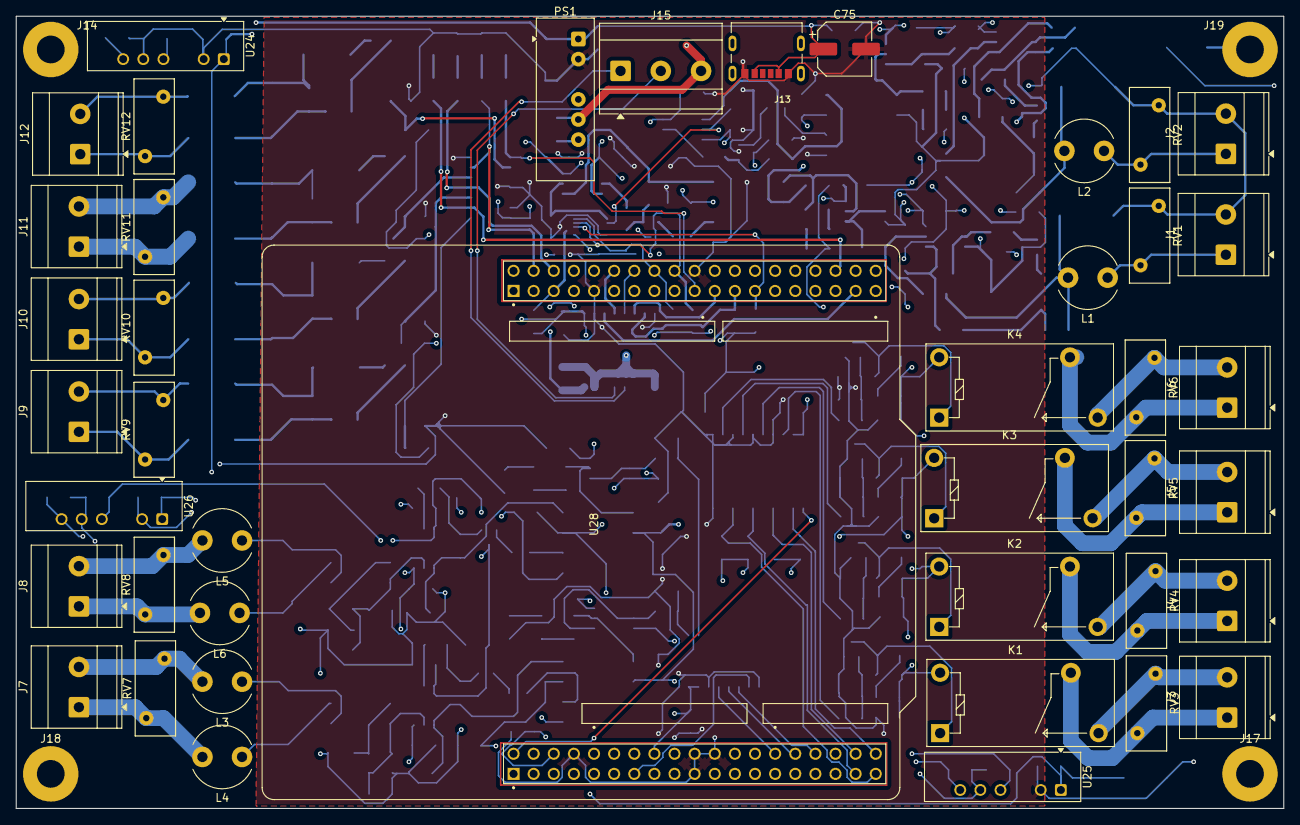
[picture p15: board IO_device.kicad_pcb from above]

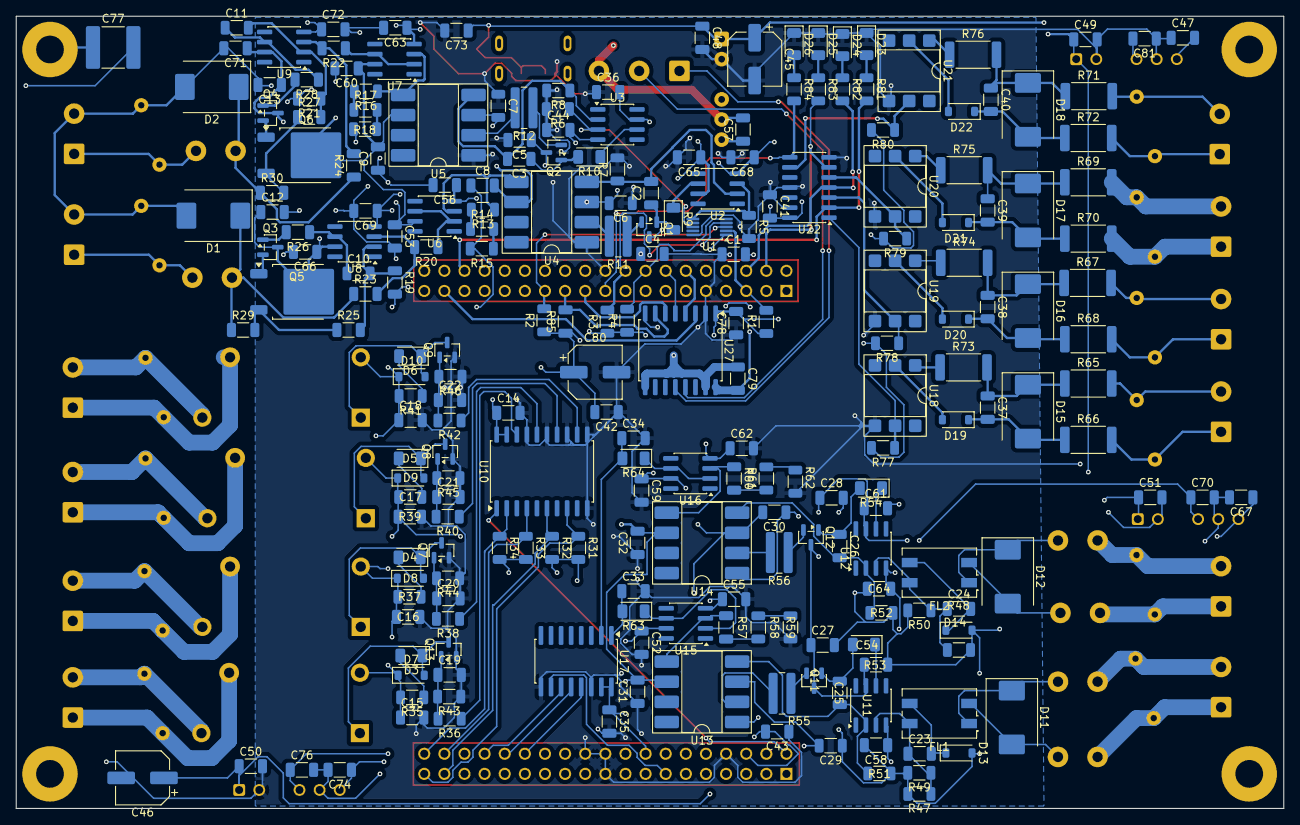
[picture p16: board IO_device.kicad_pcb from below]

Board: 4 copper layers, 160.0 x 100.0 mm, 274 parts (228 on the bottom side), 162 nets.
