Mikrovawe/KiCad2/(commit log)

2026-02-03 IO and AO added in functional blocks
    [AI.kicad_sch, AO.kicad_sch, CPU.kicad_sch]
2026-02-04 alueet laatikoitu, ensimmäiset input osat laitettu
    [CPU.kicad_sch, Communication.kicad_sch, DI.kicad_sch, DO.kicad_sch, IO_device.kicad_pcb, power.kicad_sch]
2026-02-05 Janin templaten mukainen
    [IO_device.kicad_pcb]
2026-02-08 missing AO and power
    [IO_device.kicad_pcb]
2026-02-09 all components in place
    [IO_device.kicad_pcb]
2026-02-09 some of wiring done
    [IO_device.kicad_pcb]
2026-02-11 wiring part 2
    [IO_device.kicad_pcb]
2026-02-15 started wiring
    [IO_device.kicad_pcb]
2026-03-07 all routed, no errors, missing copper
    [IO_device.kicad_pcb]
2026-03-13 copper done
    [IO_device.kicad_pcb]
